wlmeng11/SimpleRick/hardware/v1.1/DSCN7790.JPG

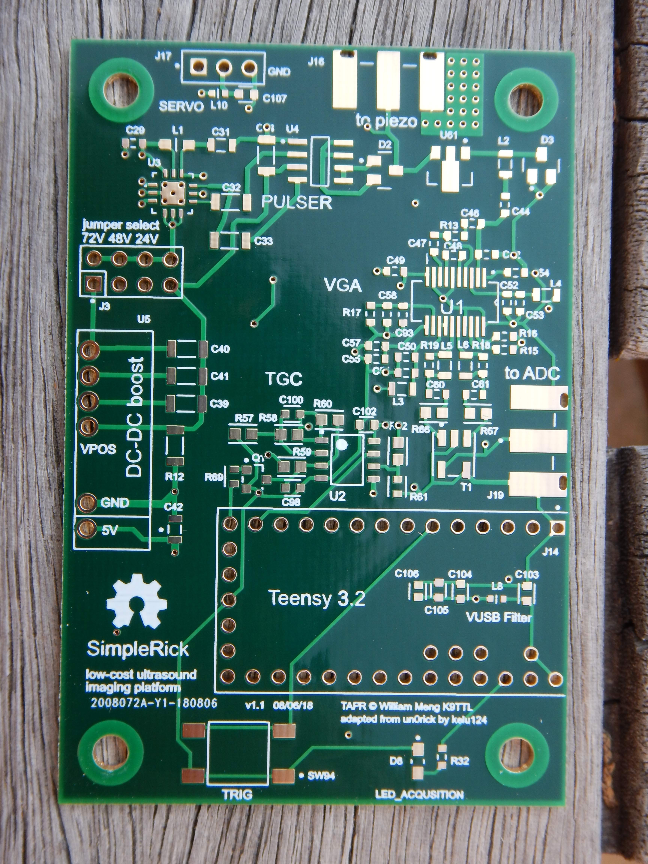
hardware/v1.1/DSCN7790.JPG
