wlmeng11/SimpleRick/hardware/v1.1/SimpleRick_BOM_v1.1.xlsx

Reference Designator | Description | Manufacturer | Manufacturer Part Number | Package | Quantity | Capacitance | Voltage | Tolerance | Dielectric
C100 | General Specification Capacitor | AVX | 06031A8R0CAT2A | 603 | 1 | 8.0pF | 100V
C102 C105 C107 | Surface - Mount Ceramic Multilayer Capacitors | YAGEO | CC0603ZRY5V7BB105 | 603 | 3 | 1ÂµF | 16V
C103 | SURFACE-MOUNT CERAMIC MULTILAYER CAPACITORS | YAGEO | CC0603KRX7R9BB103 | 603 | 1 | 10nF | 50V | Â±10%
C104 C98 | Multilayer Ceramic Capacitors MLCC - SMD/SMT 0603 0.1uF 10volts X7R 5% | Vishay | VJ0603Y104JXQCW1BC | 603 | 2 | 100.0nF | 10V
C106 | CAP CER 4.7UF 10V X5R 0603 | Kemet | C0603C475K8PACTU | 603 | 1 | 4.7ÂµF | 10V
C29 C44 C47 C48 C51 C53 C54 C55 C58 C60 C61 | Generic Capacitor (Non-Polarized) (1e-07F) | Generic | Capacitor (1e-07F) | 0603 (1608 metric) | 11 | 1e-07F | 10v | 10% | X7R
C31 C42 | Generic Capacitor (Non-Polarized) (1e-06F) | Generic | Capacitor (1e-06F) | 0805 (2012 metric) | 2 | 1e-06F | 10V | 10% | X7R
C34 | Generic Capacitor (Non-Polarized) (1e-06F) | Generic | Capacitor (1e-06F) | 1206 (3216 metric) | 1 | 1e-06F | 100V | 10% | X7R
C39 C40 C41 C32 C33 | Generic Capacitor (Non-Polarized) (1e-08F) | Generic | Capacitor (1e-08F) | 1206 (3216 metric) | 5 | 1e-08F | 100V | 10% | X7R
C46 | Generic Capacitor (Non-Polarized) (1.8e-08F) | Generic | Capacitor (1.8e-08F) | 0603 (1608 metric) | 1 | 1.8e-08F | 10v | 10% | X7R
C50 C52 C49 C57 C93 | Generic Capacitor (Non-Polarized) (1e-09F) | Generic | Capacitor (1e-09F) | 0603 (1608 metric) | 5 | 1e-09F | 10v | 10% | X7R
C92 | Generic Capacitor (Non-Polarized) (2.2e-11F) | Generic | Capacitor (2.2e-11F) | 0603 (1608 metric) | 1 | 2.2e-11F | 10v | 5% | COG
D2 D3 | High Conductance Ultra-Fast Switching Diode | Fairchild | BAV99 | SOT-23-3 | 2 |  | 70V
D8 | 2.0x1.25mm SMD CHIP LED LAMP | Kingbright | APT2012SGC | 0805 (2012 metric) | 1 | 15pF
J14 | Teensy USB Development Board | PJRC | Teensy 3.2 |  | 1
J16 J19 | SMA JACK, EDGE MOUNT, 50 OHMS, EWR-11795 SMA-J/PCB | Molex | 73251-1150 | CONN_SMA_SMD | 2
J17 | 3 pin Header, 0.1" / 2.54mm Pitch, Through-hole, Generic | Generic | 3 Pin Header |  | 1
J3 | 2.54mm Pitch C-GridÂ® Breakaway Header, Dual Row, Vertical, High Temperature, 8 Circuits, 0.38Âµm Gold (Au) Selective Plating, Tin (Sn) PC Tail Plating, 2.72mm PC Tail | Molex | 10-89-7082 | HDR10 | 1
L1 | Chip Ferrite Bead | MURATA | BLM21PG121SN1D | 0805 (2012 metric) | 1
L10 L8 | Chip Ferrite Bead | Murata | BLM18AG601SN1D | 603 | 2
L2 L3 L4 L5 L6 | Generic Inductor (1e-07H) | Generic | Inductor (1e-07H) | 0805 (2012 metric) | 5
M187 M188 M189 M190 | Mounting Hole M3 | generic | Mounting Hole M3 |  | 4
Q1 | ONSC-NPN-B1E2C3-3 | On Semiconductor | MMBT6429LT1G | SOT-23-3-318-08 | 1
R12 | Generic Resistor (100000) | Generic | Resistor (100000) | 1206 (3216 metric) | 1 |  |  | 1%
R13 | Generic Resistor (280) | Generic | Resistor (280) | 0603 (1608 metric) | 1 |  |  | 1%
R15 R16 | Generic Resistor (10000) | Generic | Resistor (10000) | 0603 (1608 metric) | 2 |  |  | 1%
R17 | Generic Resistor (11000) | Generic | Resistor (11000) | 0603 (1608 metric) | 1 |  |  | 1%
R18 R19 | Generic Resistor (100) | Generic | Resistor (100) | 0603 (1608 metric) | 2 |  |  | 1%
R32 | Generic Resistor (2K2) | Generic | Resistor (2K2) | 0603 (1608 metric) | 1 |  |  | 1%
R57 R58 R59 R60 | RES Thick Film SMD 10kÎ© 1% 1/10W 0603 100ppm/K | Vishay | CRCW060310K0FKEA | 0603 (1608 Metric) | 4 |  | 75V | 1%
R61 R69 | Thick Film Resistors - SMD 0603 2.4Kohms 1% AEC-Q200 | Panasonic | ERJ-3EKF2401V | 603 | 2
R62 | RES Thick Film SMD 9.1kÎ© 1% 1/10W 0603 100ppm/K | Vishay | CRCW06039K10FKEA | 0603 (1608 Metric) | 1 |  | 75V | 1%
R66 R67 | RES Thick Film SMD 237Î© 1% 1/10W 0603 100ppm/ÂºC | Yageo | RC0603FR-07237RL | 0603 (1608 Metric) | 2 |  | 75V | 1%
SW94 | Tactile Switches SPST OFF-(ON) 3VA BLK FLAT BUTTON SMT | NKK | HP0315AFKP2-R | SW_6MM2_6MM2_SMT_4 | 1
T1 | TRANSFORMER FOR WIDEBAND RF APP | Pulse Electronics Network | CX2041NL | SMT_TRASNFORMER_3MM81_3MM81 | 1
TP1 TP10 TP11 TP12 TP13 TP14 TP15 TP16 TP17 TP2 TP3 TP4 TP5 TP6 TP7 TP8 TP9 | SMT Test Point | Keystone | 5019 | SMT_TP_3MM83_2MM03 | 17
U1 |  | ANALOG DEVICES | AD8331ARQZ | SOP64P600X165-20N | 1
U2 | AMP-OPA-LM6132-8 | TI National Semiconductor | LMV722M/NOPB | MS-012-AA | 1
U3 | High Speed Dual MOSFET Driver | MICROCHIP | MD1210K6-G | QFN12 | 1
U4 | Standard | Supertex | TC6320TG-G | SO | 1
U5 | Triple Output 3W DC/DC Converters | MURATA | NMT0572SC | SIP8 | 1
U61 | HIGH VOLTAGE PROTECT T/R SWITCH | MICROCHIP | MD0100N8-G | SOT89-3 | 1
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
