wlmeng11/SimpleRick/hardware/v1.1/SimpleRick_v1.1.pdf

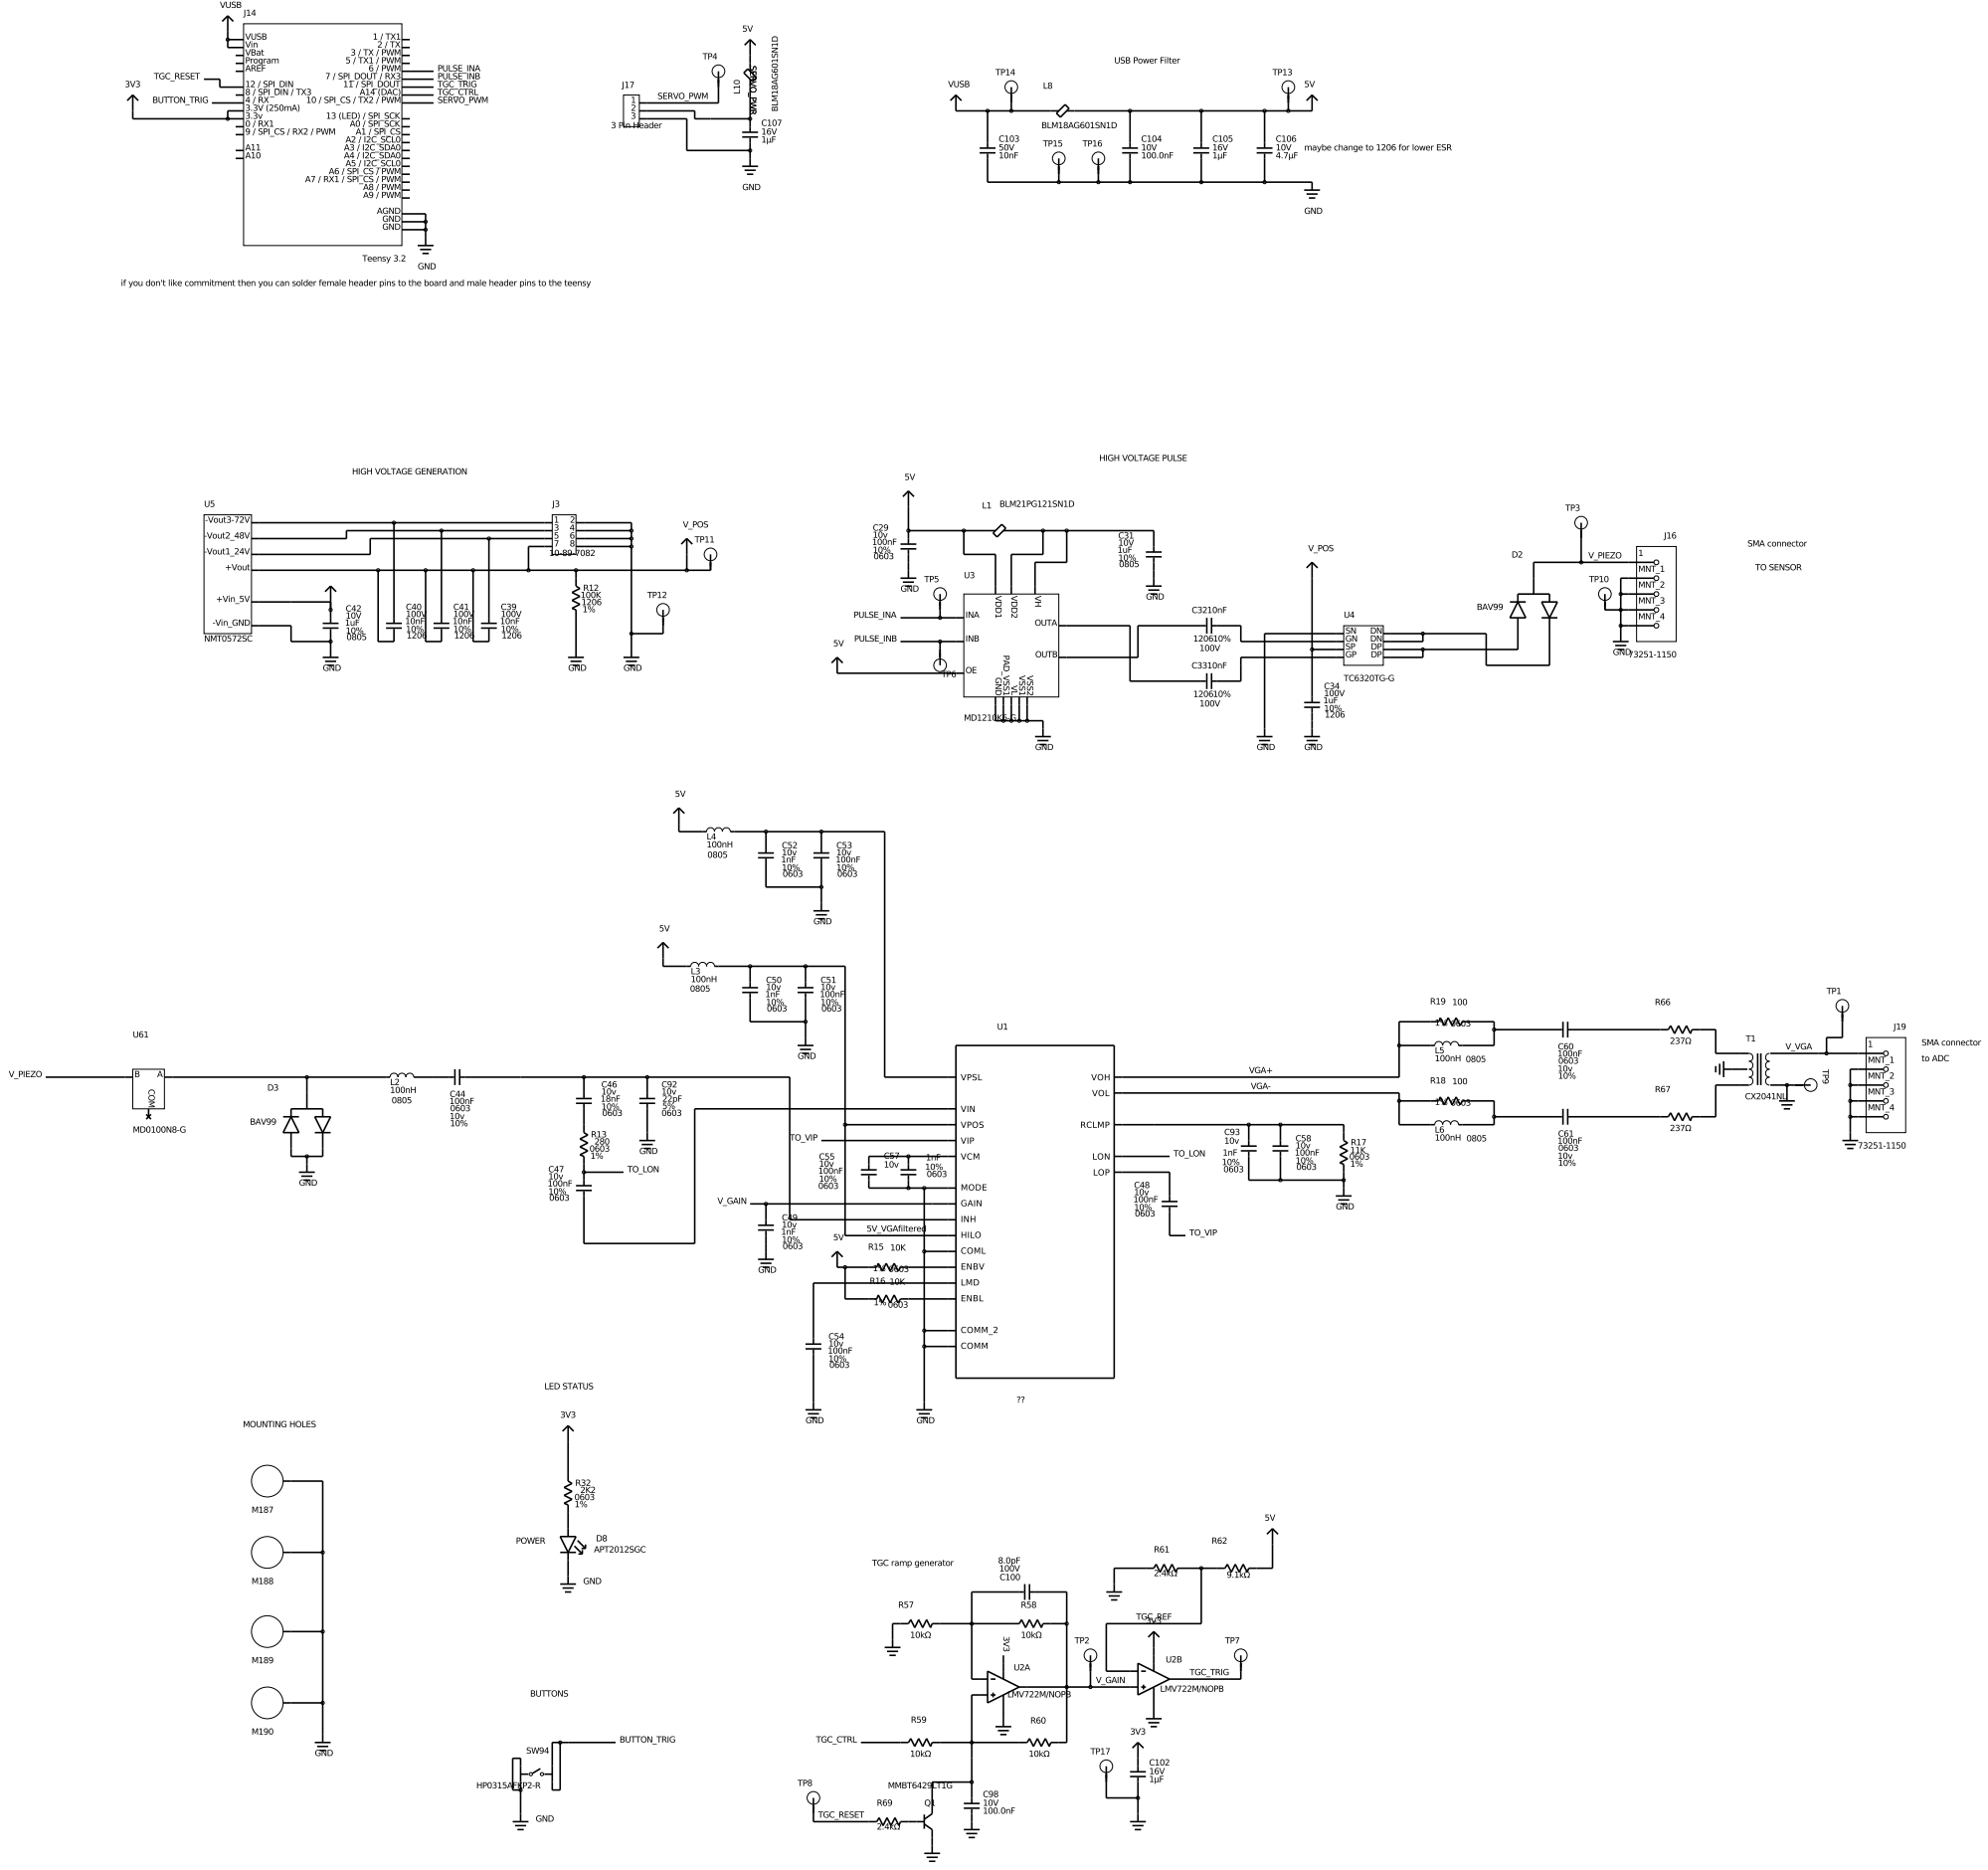
[picture p17: page 1]
