wlmeng11/SimpleRick/experiments/20180807/HackRF_ultrasound_simulator.png

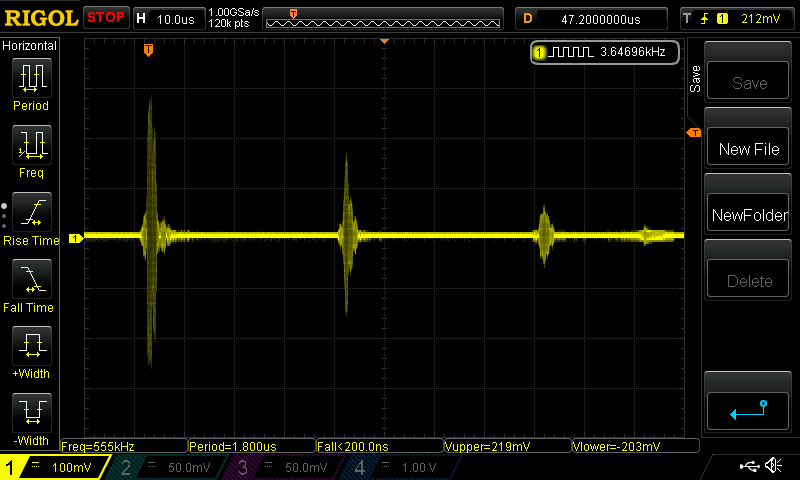
experiments/20180807/HackRF_ultrasound_simulator.png
