wlmeng11/SimpleRick/(commit log)

2018-08-11 Design files for PCB v1.1
    [SimpleRick_BOM_v1.1.xlsx]
2018-08-17 TGC self-calibration
2018-08-20 Only do scanlines when user button is pressed
2018-08-20 Motor sweep
2018-08-21 Successful test of servo motion
2018-08-22 Update initial servo angle
2018-10-13 Github traffic stats
    [2018-09-03-23h-58m-clone-stats.csv, 2018-09-03-23h-58m-referrer-stats.csv, 2018-09-03-23h-58m-traffic-stats.csv, 2018-09-26-22h-58m-clone-stats.csv, 2018-09-26-22h-58m-referrer-stats.csv, 2018-09-26-22h-58m-traffic-stats.csv, 2018-10-13-12h-02m-clone-stats.csv, 2018-10-13-12h-02m-referrer-stats.csv]
2018-11-19 Update traffic stats
    [2018-11-18-22h-38m-clone-stats.csv, 2018-11-18-22h-38m-referrer-stats.csv, 2018-11-18-22h-38m-traffic-stats.csv]
